simonyiszk/STM32-RedPill/RedPill_board/fab/BOM_RedPill_Rev_A.xlsx

Comment | Designator | Footprint | JLCPCB Part #（optional）
RESET | SW1 | SW_SPST_TL3342 | C318884
100n | C5,C17,C12,C18,C7,C15,C2,C1,C16,C19,C3 | C_0603_1608Metric | C14663
4.7uF | C13 | C_0805_2012Metric | C1779
4k7 | R16,R17 | R_0603_1608Metric | C23162
36k | R12 | R_0603_1608Metric | C23147
20p | C6,C10,C4,C11 | C_0603_1608Metric | C1648
AMS1117-3.3 | U2 | SOT-223-3_TabPin2 | C6186
220 | R3,R15,R2 | R_0603_1608Metric | C22962
22 | R19,R23,R22,R27,R25,R24,R20,R21 | R_0603_1608Metric | C23345
5k1 | R7,R8 | R_0603_1608Metric | C23186
10k | R6,R18,R26,R11,R5 | R_0603_1608Metric | C25804
1k5 | R10 | R_0603_1608Metric | C22843
RED | D2 | LED_0603_1608Metric | C2286
100 | R13,R14,R9 | R_0603_1608Metric | C22775
GREEN | D1 | LED_0603_1608Metric | C72043
1u | C9,C8,C14 | C_0603_1608Metric | C15849
100k | R1,R4 | R_0603_1608Metric | C25803
PWR | D3 | LED_0603_1608Metric | C2286
FCM32F103CBT6 | U1 | LQFP-48_7x7mm_P0.5mm | C2972837
S9013 | Q1 | SOT-23 | C6749
STM32F401RCT6 | U3 | LQFP-64_10x10mm_P0.5mm | C74524
USB_C_Receptacle_USB2.0 | J2 | USB_C_Receptacle_G-Switch_GT-USB-7010ASV | C2765186
8MHz | Y1 | Crystal_SMD_5032_2pin | C115962
BEAD | L1 | L_0603_1608Metric | C1002
1A | F1 | Fuse_1206_3216Metric | C883131
