simonyiszk/STM32-RedPill/RedPill_board/RedPill_board.kicad_pcb

## KiCad design RedPill_board/RedPill_board.kicad_pcb (2023-08-24)

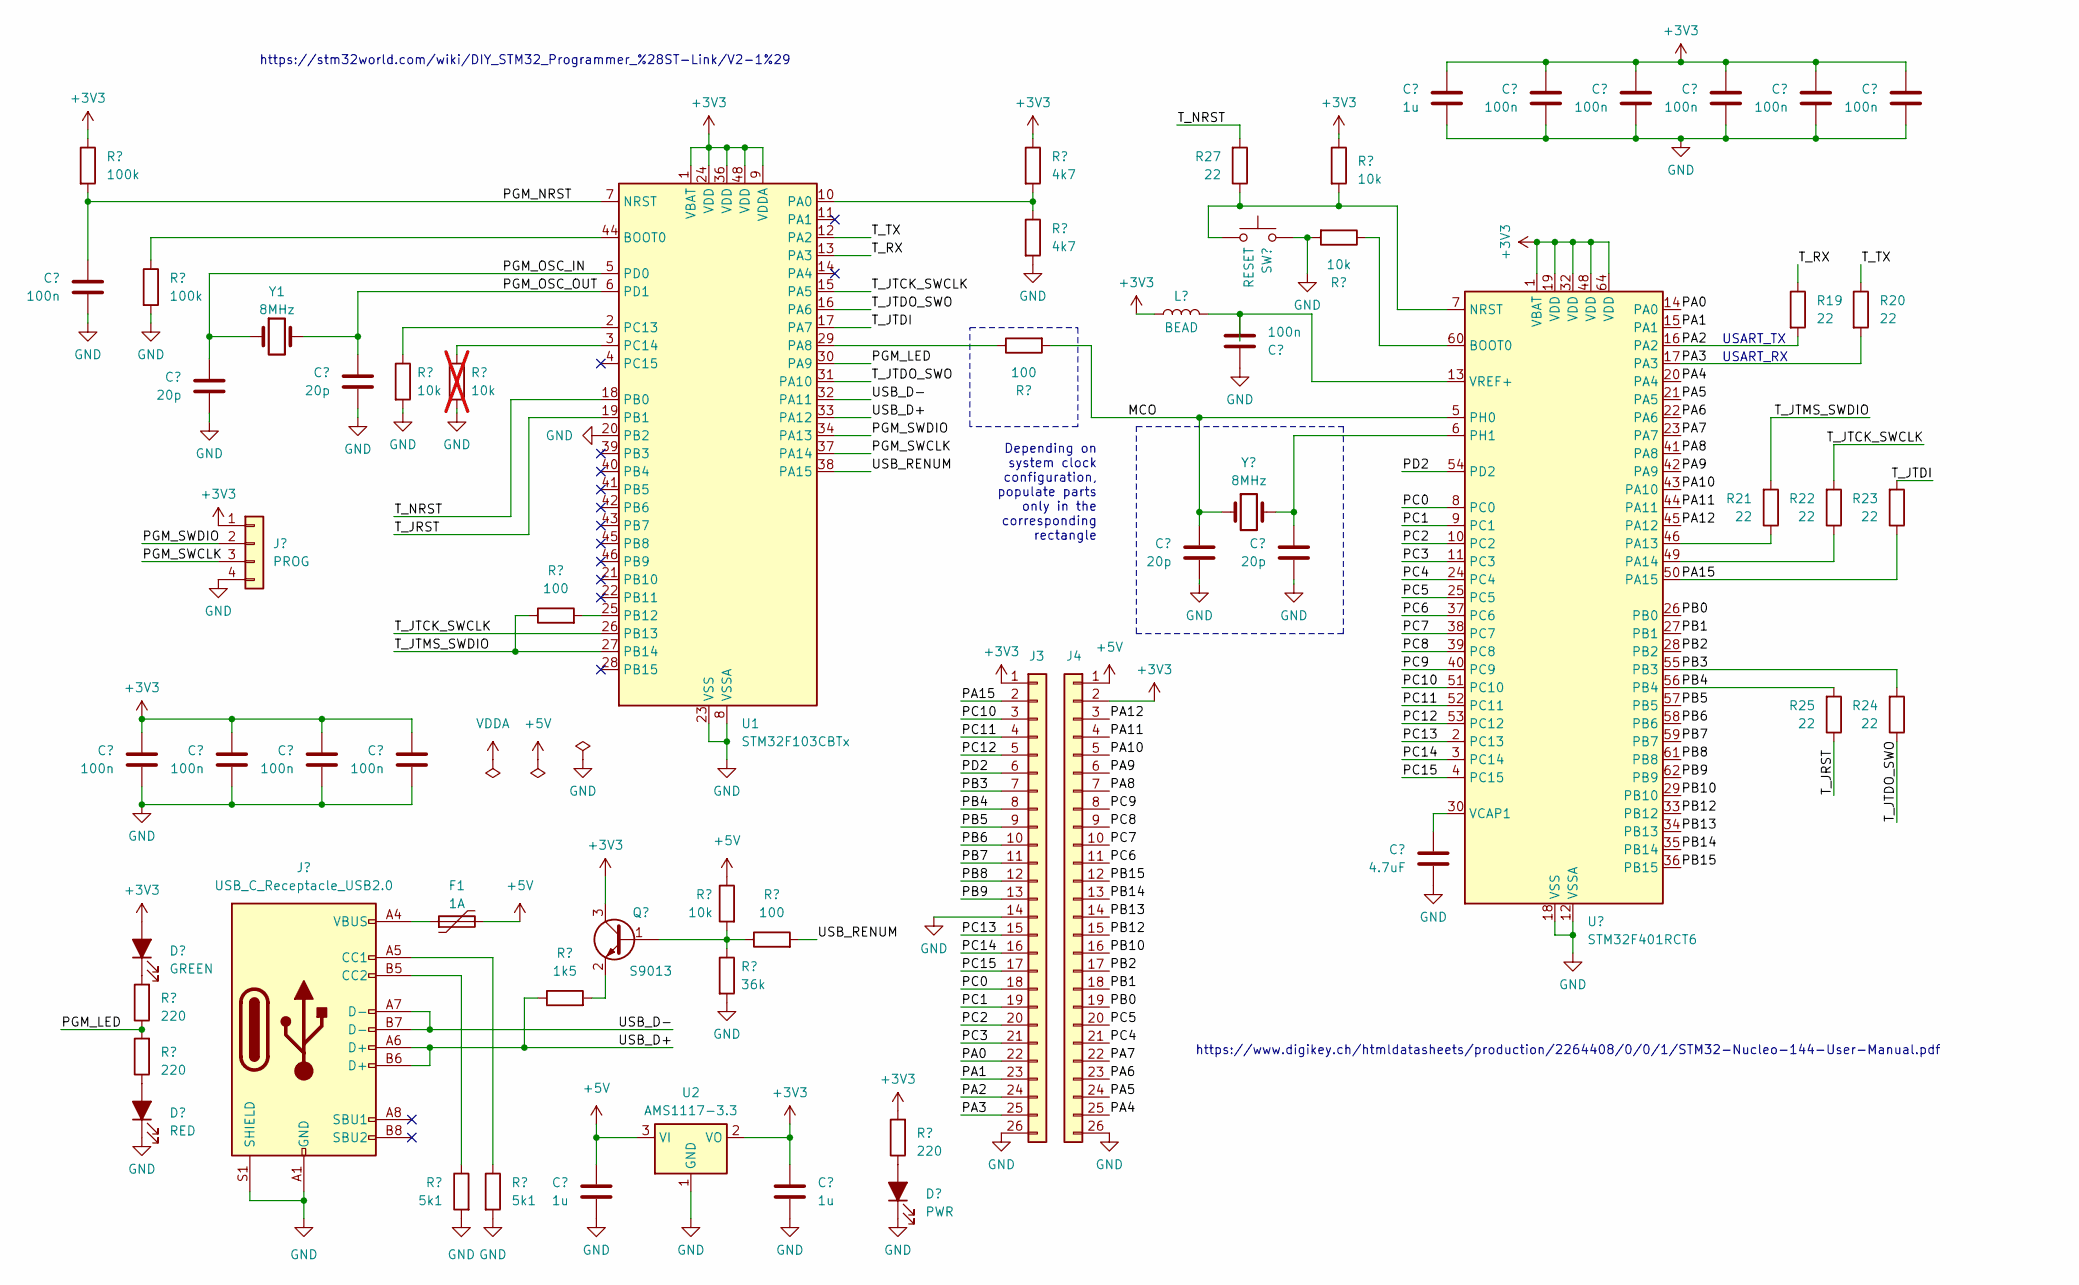
[picture p1: schematic RedPill_board.kicad_sch, STM32 RedPill]

Parts:
C1, C2, C3, C5, C7, C12, C15, C16, C17, C18, C19: 100n; C_0603_1608Metric
C4, C6, C10, C11: 20p; C_0603_1608Metric
C8, C9, C14: 1u; C_0603_1608Metric
C13: 4.7uF; C_0805_2012Metric
D1: GREEN; LED_0603_1608Metric
D2: RED; LED_0603_1608Metric
D3: PWR; LED_0603_1608Metric
F1: 1A; Fuse_1206_3216Metric
J1: PROG; PinHeader_1x04_P1.27mm_Vertical
J2: USB_C_Receptacle_USB2.0; USB_C_Receptacle_G-Switch_GT-USB-7010ASV
J3, J4: Conn_01x26; PinHeader_1x26_P2.54mm_Vertical
L1: BEAD; L_0603_1608Metric
Q1: S9013; SOT-23
R1, R4: 100k; R_0603_1608Metric
R2, R3, R15: 220; R_0603_1608Metric
R5, R11, R18, R26: 10k; R_0603_1608Metric
R6: 10k; R_0603_1608Metric; not fitted
R7, R8: 5k1; R_0603_1608Metric
R9, R13, R14: 100; R_0603_1608Metric
R10: 1k5; R_0603_1608Metric
R12: 36k; R_0603_1608Metric
R16, R17: 4k7; R_0603_1608Metric
R19, R20, R21, R22, R23, R24, R25, R27: 22; R_0603_1608Metric
SW1: RESET; SW_SPST_TL3342
U1: STM32F103CBTx; LQFP-48_7x7mm_P0.5mm
U2: AMS1117-3.3; SOT-223-3_TabPin2
U3: STM32F401RCT6; LQFP-64_10x10mm_P0.5mm
Y1: 8MHz; Crystal_SMD_5032-2Pin_5.0x3.2mm
Y2: 8MHz; Crystal_HC49-4H_Vertical

Connections:
+3V3: C2.1, C3.1, C5.1, C7.1, C9.1, C14.1, C15.1, C16.1, C17.1, C18.1, C19.1, D1.2 (A), J1.1, J3.1, J4.2, L1.1, Q1.3 (C), R1.1, R15.2, R16.1, R26.1, U1.1 (VBAT), U1.9 (VDDA), U1.24 (VDD), U1.36 (VDD), U1.48 (VDD), U2.2 (VO), U3.1 (VBAT), U3.19 (VDD), U3.32 (VDD), U3.48 (VDD), U3.64 (VDD)
+5V: C8.1, F1.2, J4.1, R11.1, U2.3 (VI)
/MCO: C10.1, R14.2, U3.5 (PH0), Y2.1
/PA0: J3.22, U3.14 (PA0)
/PA1: J3.23, U3.15 (PA1)
/PA2: J3.24, R19.2, U3.16 (PA2)
/PA3: J3.25, R20.2, U3.17 (PA3)
/PA4: J4.25, U3.20 (PA4)
/PA5: J4.24, U3.21 (PA5)
/PA6: J4.23, U3.22 (PA6)
/PA7: J4.22, U3.23 (PA7)
/PA8: J4.7, U3.41 (PA8)
/PA9: J4.6, U3.42 (PA9)
/PA10: J4.5, U3.43 (PA10)
/PA11: J4.4, U3.44 (PA11)
/PA12: J4.3, U3.45 (PA12)
/PA15: J3.2, R23.1, U3.50 (PA15)
/PB0: J4.19, U3.26 (PB0)
/PB1: J4.18, U3.27 (PB1)
/PB2: J4.17, U3.28 (PB2)
/PB3: J3.7, R24.2, U3.55 (PB3)
/PB4: J3.8, R25.2, U3.56 (PB4)
/PB5: J3.9, U3.57 (PB5)
/PB6: J3.10, U3.58 (PB6)
/PB7: J3.11, U3.59 (PB7)
/PB8: J3.12, U3.61 (PB8)
/PB9: J3.13, U3.62 (PB9)
/PB10: J4.16, U3.29 (PB10)
/PB12: J4.15, U3.33 (PB12)
/PB13: J4.14, U3.34 (PB13)
/PB14: J4.13, U3.35 (PB14)
/PB15: J4.12, U3.36 (PB15)
/PC0: J3.18, U3.8 (PC0)
/PC1: J3.19, U3.9 (PC1)
/PC2: J3.20, U3.10 (PC2)
/PC3: J3.21, U3.11 (PC3)
/PC4: J4.21, U3.24 (PC4)
/PC5: J4.20, U3.25 (PC5)
/PC6: J4.11, U3.37 (PC6)
/PC7: J4.10, U3.38 (PC7)
/PC8: J4.9, U3.39 (PC8)
/PC9: J4.8, U3.40 (PC9)
/PC10: J3.3, U3.51 (PC10)
/PC11: J3.4, U3.52 (PC11)
/PC12: J3.5, U3.53 (PC12)
/PC13: J3.15, U3.2 (PC13)
/PC14: J3.16, U3.3 (PC14)
/PC15: J3.17, U3.4 (PC15)
/PD2: J3.6, U3.54 (PD2)
/PGM_LED: R2.1, R3.2, U1.30 (PA9)
/PGM_NRST: C1.1, R1.2, U1.7 (NRST)
/PGM_OSC_IN: C4.1, U1.5 (PD0), Y1.1
/PGM_OSC_OUT: C6.1, U1.6 (PD1), Y1.2
/PGM_SWCLK: J1.3, U1.37 (PA14)
/PGM_SWDIO: J1.2, U1.34 (PA13)
/T_JRST: R25.1, U1.19 (PB1)
/T_JTCK_SWCLK: R22.2, U1.15 (PA5), U1.26 (PB13)
/T_JTDI: R23.2, U1.17 (PA7)
/T_JTDO_SWO: R24.1, U1.16 (PA6), U1.31 (PA10)
/T_JTMS_SWDIO: R9.1, R21.2, U1.27 (PB14)
/T_NRST: R27.2, U1.18 (PB0)
/T_RX: R19.1, U1.13 (PA3)
/T_TX: R20.1, U1.12 (PA2)
/USB_D+: J2.A6 (D+), J2.B6 (D+), R10.1, U1.33 (PA12)
/USB_D-: J2.A7 (D-), J2.B7 (D-), U1.32 (PA11)
/USB_RENUM: R13.2, U1.38 (PA15)
GND: C1.2, C2.2, C3.2, C4.2, C5.2, C6.2, C7.2, C8.2, C9.2, C10.2, C11.2, C12.1, C13.2, C14.2, C15.2, C16.2, C17.2, C18.2, C19.2, D2.1 (K), D3.1 (K), J1.4, J2.A1 (GND), J2.A12 (GND), J2.B1 (GND), J2.B12 (GND), J2.S1 (SHIELD), J3.14, J3.26, J4.26, R4.2, R5.2, R6.2, R7.2, R8.2, R12.2, R17.2, R18.2, SW1.2, U1.8 (VSSA), U1.20 (PB2), U1.23 (VSS), U1.35 (VSS), U1.47 (VSS), U2.1 (GND), U3.12 (VSSA), U3.18 (VSS), U3.31 (VSS), U3.47 (VSS), U3.63 (VSS)
unnamed: D1.1 (K), R2.2
unnamed: D2.2 (A), R3.1
unnamed: D3.2 (A), R15.1
unnamed: F1.1, J2.A4 (VBUS), J2.A9 (VBUS), J2.B4 (VBUS), J2.B9 (VBUS)
unnamed: J2.A5 (CC1), R8.1
unnamed: J2.B5 (CC2), R7.1
unnamed: Q1.1 (B), R11.2, R12.1, R13.1
unnamed: Q1.2 (E), R10.2
unnamed: R4.1, U1.44 (BOOT0)
unnamed: R16.2, R17.1, U1.10 (PA0)
unnamed: R14.1, U1.29 (PA8)
unnamed: R9.2, U1.25 (PB12)
unnamed: R5.1, U1.2 (PC13)
unnamed: R6.1, U1.3 (PC14)
unnamed: R18.1, U3.60 (BOOT0)
unnamed: R26.2, R27.1, SW1.1, U3.7 (NRST)
unnamed: R21.1, U3.46 (PA13)
unnamed: R22.1, U3.49 (PA14)
unnamed: C11.1, U3.6 (PH1), Y2.2
unnamed: C13.1, U3.30 (VCAP1)
unnamed: C12.2, L1.2, U3.13 (VREF+)

Notes on the sheet:
Depending on system clock configuration, populate parts only in the corresponding rectangle
https://stm32world.com/wiki/DIY_STM32_Programmer_%28ST-Link/V2-1%29
USART_RX
USART_TX
https://www.digikey.ch/htmldatasheets/production/2264408/0/0/1/STM32-Nucleo-144-User-Manual.pdf

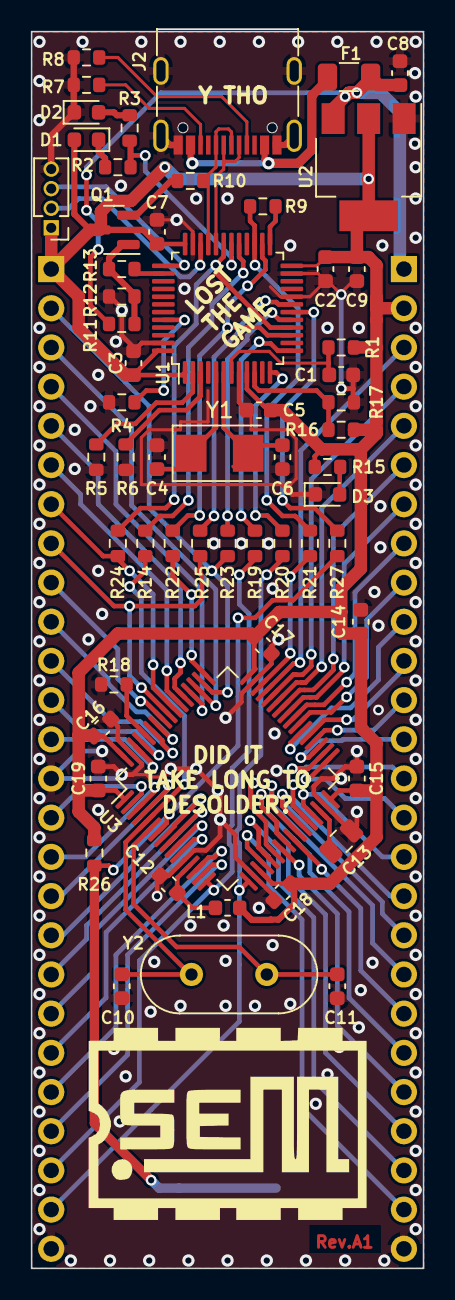
[picture p2: board RedPill_board.kicad_pcb from above]

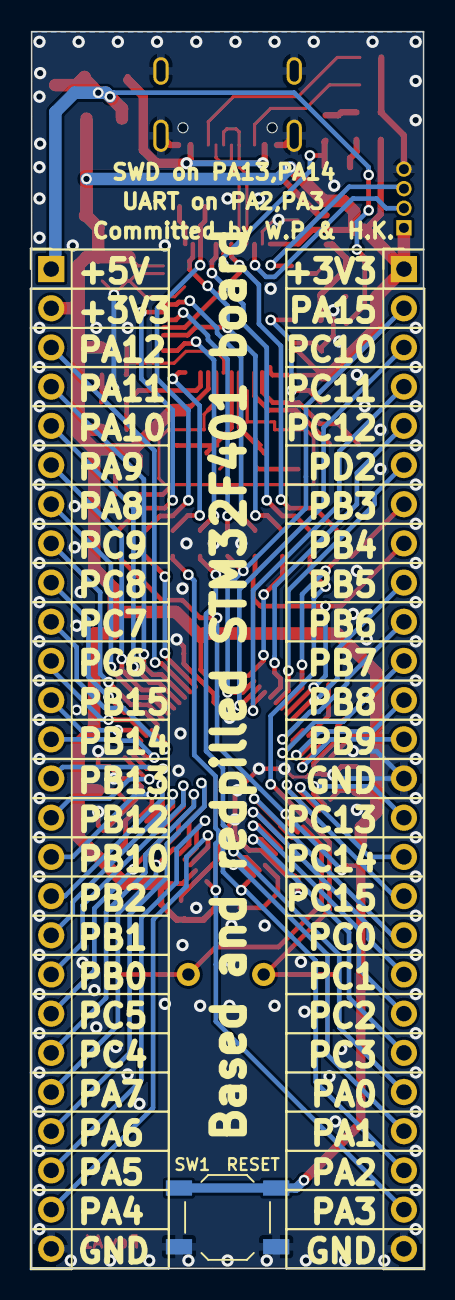
[picture p3: board RedPill_board.kicad_pcb from below]

Board: 2 copper layers, 25.4 x 80.2 mm, 62 parts (3 on the bottom side), 88 nets.
