simonyiszk/STM32-RedPill/RedPill_example/RedPill_example.ioc

Mcu.UserName=STM32F401RCTx
PA13.Signal=SYS_JTMS-SWDIO
PA14.Signal=SYS_JTCK-SWCLK
PA2.Signal=USART2_TX
PA3.Signal=USART2_RX
