simonyiszk/STM32-RedPill/(commit log)

2023-06-29 Add kicad project containing main board with initial schematic
    [RedPill_board.kicad_pcb, RedPill_board.kicad_sch]
2023-06-30 Cleanup programming nets and components, add blank connectors and initial pcb design
    [RedPill_board.kicad_pcb, RedPill_board.kicad_sch]
2023-07-22 Minor modifications
    [RedPill_board.kicad_pcb, RedPill_board.kicad_sch]
2023-07-23 Fit parts on top side
    [RedPill_board.kicad_pcb]
2023-08-06 Routing in progress.
    [RedPill_board.kicad_pcb, RedPill_board.kicad_sch]
2023-08-07 Added texts and logo.
    [RedPill_board.kicad_pcb]
2023-08-08 Sent to fab.
    [BOM_RedPill_Rev_A.xlsx, RedPill_board.kicad_pcb, RedPill_board.kicad_sch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]
2023-08-24 Revision A1 + UART test firmware.
    [RedPill_board.kicad_pcb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]
